wangloo/lora_gateway/LoRa_Gateway_V2.0/README.txt

STM32Cube MX +keil 来维护整个工程
cleanbuildfiles.bat 删除编译产生的临时文件
