wangloo/lora_gateway/Doc/协议1.0.pdf

## 上传数据报格式

NAME | 网关号 GateWayID | 结点号 NodeID | 数据报类型 Flag | 温度 Temp | 湿度 Humi | 电量 Battery
VALUE | | | 1
TYPE | u8 | u8 | u8 | u8 | u8 | u8

### {"GateWayID":1,"NodeID":0,"Flag":1,"Temp":20,"Humi":70,"Battery":100}

## 下发数据报格式

NAME | 网关号 GateWayID | 结点号 NodeID | 数据报类型 Flag | 灯 Led | 水泵 Pump | 显示器 Lcd
VALUE | | | 2 | 0/1 | 0/1 | str
TYPE | u8 | u8 | u8 | u8 | u8 | u8 *

### {"GateWayID":1,"NodeID":0,"Flag":2,"Led":1,"Pump":1,"Lcd":"Hello World!"}

### 结点号 255 表示本网内广播
