wangloo/lora_gateway/LoRa_Node/Inc/main.h

#define LED_R_Pin GPIO_PIN_0
#define LED_R_GPIO_Port GPIOB
#define LED_G_Pin GPIO_PIN_1
#define LED_G_GPIO_Port GPIOB
#define LoRa_DIO0_Pin GPIO_PIN_10
#define LoRa_DIO0_GPIO_Port GPIOB
#define LoRa_DIO0_EXTI_IRQn EXTI15_10_IRQn
#define LoRa_RST_Pin GPIO_PIN_11
#define LoRa_RST_GPIO_Port GPIOB
#define SPI2_NSS_Pin GPIO_PIN_12
#define SPI2_NSS_GPIO_Port GPIOB
