wangloo/lora_gateway/LoRa_Gateway_V2.0/HARDWARE/LORA/sx1276-board.h

/**********************************************
 * BSP of AiThinker LoRa module(ra-01)
 * Test hardware: STM32F103RCT6; 72M
 * 
 * Create by Wanglu in QingDao University 
 * Used for the graduation project		
 *  
 * Last update time: 2021/07/02
 *********************************************/	
 
#ifndef __SX1276_ARCH_H__
#define __SX1276_ARCH_H__
#include "stdbool.h"
#include "stdint.h"
#include "sx1276.h"
#include "sx1276_config.h"
#include "sys.h"

/* 复位脚----PC4 */
#define SX1278_RST_PIN_INDEX	GPIO_PIN_4
#define SX1278_RST_PIN_GROUP	GPIOC

/* SPI使用的是spi1(PA5/6/7)，片选使用的PA4 */
#define SX1278_CS_PIN_INDEX   	GPIO_PIN_4
#define SX1278_CS_PIN_GROUP   	GPIOA
#define SX1278_SCK_PIN_INDEX	  GPIO_PIN_5
#define SX1278_SCK_PIN_GROUP	  GPIOA
#define SX1278_MISO_PIN_INDEX	  GPIO_PIN_6
#define SX1278_MISO_PIN_GROUP	  GPIOA
#define SX1278_MOSI_PIN_INDEX	  GPIO_PIN_7
#define SX1278_MOSI_PIN_GROUP	  GPIOA

/* DIO0引脚(这里修改了需要手动修改中断初始化和中断函数) */
#define SX1278_DIO0_PIN_INDEX	  GPIO_PIN_0
#define SX1278_DIO0_PIN_GROUP	  GPIOC
/* DIO1引脚(这里修改了需要手动修改中断初始化和中断函数) */
#define SX1278_DIO1_PIN_INDEX	  GPIO_PIN_1
#define SX1278_DIO1_PIN_GROUP	  GPIOC

/*!
 * \brief Radio hardware registers initialization definition
 *
 * \remark Can be automatically generated by the SX1276 GUI (not yet implemented)
 */
#define RADIO_INIT_REGISTERS_VALUE                \
{                                                 \
    { MODEM_FSK , REG_LNA                , 0x23 },\
    { MODEM_FSK , REG_RXCONFIG           , 0x1E },\
    { MODEM_FSK , REG_RSSICONFIG         , 0xD2 },\
    { MODEM_FSK , REG_AFCFEI             , 0x01 },\
    { MODEM_FSK , REG_PREAMBLEDETECT     , 0xAA },\
    { MODEM_FSK , REG_OSC                , 0x07 },\
    { MODEM_FSK , REG_SYNCCONFIG         , 0x12 },\
    { MODEM_FSK , REG_SYNCVALUE1         , 0xC1 },\
    { MODEM_FSK , REG_SYNCVALUE2         , 0x94 },\
    { MODEM_FSK , REG_SYNCVALUE3         , 0xC1 },\
    { MODEM_FSK , REG_PACKETCONFIG1      , 0xD8 },\
    { MODEM_FSK , REG_FIFOTHRESH         , 0x8F },\
    { MODEM_FSK , REG_IMAGECAL           , 0x02 },\
    { MODEM_FSK , REG_DIOMAPPING1        , 0x00 },\
    { MODEM_FSK , REG_DIOMAPPING2        , 0x30 },\
    { MODEM_LORA, REG_LR_PAYLOADMAXLENGTH, 0x40 },\
}                                                 \

#define RF_MID_BAND_THRESH                          525000000

/*!
 * \brief Initializes the radio I/Os pins interface
 */
void SX1276IoInit( void );

/*!
 * \brief Initializes DIO IRQ handlers
 *
 * \param [IN] irqHandlers Array containing the IRQ callback functions
 */
void SX1276IoIrqInit( DioIrqHandler **irqHandlers );

/*!
 * \brief De-initializes the radio I/Os pins interface. 
 *
 * \remark Useful when going in MCU lowpower modes
 */
void SX1276IoDeInit( void );

/*!
 * \brief Gets the board PA selection configuration
 *
 * \param [IN] channel Channel frequency in Hz
 * \retval PaSelect RegPaConfig PaSelect value
 */
uint8_t SX1276GetPaSelect( uint32_t channel );

/*!
 * \brief Initializes the RF Switch I/Os pins interface
 */
void SX1276AntSwInit( void );

/*!
 * \brief De-initializes the RF Switch I/Os pins interface 
 *
 * \remark Needed to decrease the power consumption in MCU lowpower modes
 */
void SX1276AntSwDeInit( void );

/*!
 * \brief Controls the antena switch if necessary.
 *
 * \remark see errata note
 *
 * \param [IN] rxTx [1: Tx, 0: Rx]
 */
void SX1276SetAntSw( uint8_t rxTx );

/*!
 * \brief Checks if the given RF frequency is supported by the hardware
 *
 * \param [IN] frequency RF frequency to be checked
 * \retval isSupported [true: supported, false: unsupported]
 */
bool SX1276CheckRfFrequency( uint32_t frequency );


void Sx1276SetNSS(bool enable );
uint8_t Sx1276SpiInOut(uint16_t data );
void SX1276TimerInit(void);
void SX1276TxTimeoutTimerStart( uint32_t timeoutMs );
void SX1276TxTimeoutTimerStop(void);
void SX1276RxTimeoutTimerStart( uint32_t timeoutMs );
void SX1276RxTimeoutTimerStop(void);
void SX1276SyncWordTimeoutTimerStart( uint32_t timeoutMs );
void SX1276SyncWordTimeoutTimerStop(void);
void SX1276Reset( void );
void SX1276DelayMs(uint32_t delayMs);

/*!
 * Radio hardware and global parameters
 */
extern SX1276_t SX1276;

extern u16 LoRaRxPayloadLen;                /* Length of LoRa Rx payload */
extern u16 LoRaTxPayloadLen;                /* Length of LoRa Tx payload */
extern u8  LoRaRxPayload[LORA_BUFFER_SIZE]; /* LoRa Rx payload */
extern u8  LoRaTxPayload[LORA_BUFFER_SIZE]; /* LoRa Tx payload */

#endif // __SX1276_ARCH_H__
