wangloo/lora_gateway/(notices)

Notices in the files:
LoRa_Gateway_V2.0/HARDWARE/OLED/oledfont.h:
Copyright(C) ÉîÛÚÊÐÈ«¶¯µç×Ó¼¼ÊõÓÐÏÞ¹«Ë¾ 2009-2019
All rights reserved
LoRa_Gateway_V2.0/HARDWARE/ATK-ESP8266/common.c:
Copyright(C) ¹ãÖÝÊÐÐÇÒíµç×Ó¿Æ¼¼ÓÐÏÞ¹«Ë¾ 2009-2019
LoRa_Node/Src/main.c:
This software component is licensed by ST under BSD 3-Clause license,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
